kbelenky/open_sorts/src/recognizer.py

# Copyright 2022 Kennet Belenky
#
# This file is part of OpenSorts.
#
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
import json
import pickle
import platform
import sys

import tensorflow as tf
import tensorflow.keras.applications as applications
import tensorflow_addons as tfa
import cv2

import transform
import card_recognizer
import common

config = common.load_config()
transform_vector = transform.keypoints_to_transform(640, 448,
                                                    *config.camera_keypoints)

print('Loading catalog')
json_file = open("card_catalog.json", "r", encoding="utf-8")
catalog = json.load(json_file)
card_lookup = dict()
for card in catalog:
    id = card['id']
    face_index = card['face_index']
    card_id = f'{id}_{face_index}'
    card_lookup[card_id] = card

print('Initializing recognizer.')
recognizer = card_recognizer.Recognizer(catalog)

print('Creating camera.')
if platform.system() == 'Windows':
    # On Windows, the DirectShow interface seems to be faster and
    # more reliable
    print('Using DirectShow')
    vc = cv2.VideoCapture(config.camera_id, cv2.CAP_DSHOW)
else:
    vc = cv2.VideoCapture(config.camera_id)
vc.set(cv2.CAP_PROP_FRAME_WIDTH, 1280)
vc.set(cv2.CAP_PROP_FRAME_HEIGHT, 720)

print('Opening camera.')
if not vc.isOpened():
    print('Failed to open camera.')
    sys.exit()

previous_card_id = ''
while True:
    rval, frame = vc.read()
    if not rval:
        print('Error code on frame capture.')
        break

    frame = cv2.cvtColor(frame, cv2.COLOR_BGR2RGB)
    image = tfa.image.transform(frame,
                                transform_vector,
                                interpolation='bilinear',
                                fill_value=255,
                                output_shape=(448, 640))
    image, _, _ = transform.automatic_brightness_and_contrast(
        tf.image.convert_image_dtype(image, tf.uint8).numpy())
    image = tf.image.convert_image_dtype(image, tf.float32)
    image = tf.image.rot90(image, k=1)
    card_id, distance = recognizer.recognize(image)

    if card_id != previous_card_id:
        previous_card_id = card_id

        if card_id == 'Unknown':
            print(f'Unknown : {distance}')
        else:
            card = card_lookup[card_id]
            card_name = card['name']
            set_code = card['set']
            print(f'{distance} : {card_name} [{set_code}] : {card_id}')

print('Shutting down.')
vc.release()
