kbelenky/open_sorts/(commit log)

2022-03-14 Adding inital machine model and parts list.
    [parts_list.csv]
2022-03-29 Added sensor_test.py
2022-03-29 Added motor_test.py
2022-04-02 Adds the arduino sketch
2022-04-28 Fixes the path for the card catalog json.
    [recognizer.py]
2023-01-15 Removes some code having to do with fixed camera alignment, updates requirements.
2023-01-19 Adds the camera_mode utility and the corners model.
2023-01-26 Updates camera_mode.py to use the thumbnailer. Adds a few more comments.
2023-02-02 Fixes a bug introduced by the new thumbnailing code.
    [arduino_device.py]
